juliolopez/ASISTE_PCB/esquematicos.pdf

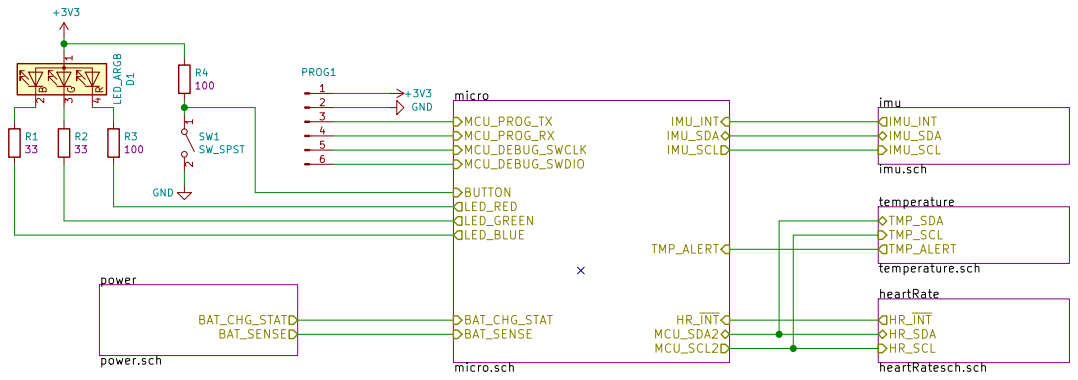
[picture p1: page 1]

Julio López Moya ASISTE

File: ASISTE.sch Sheet: / ASISTE

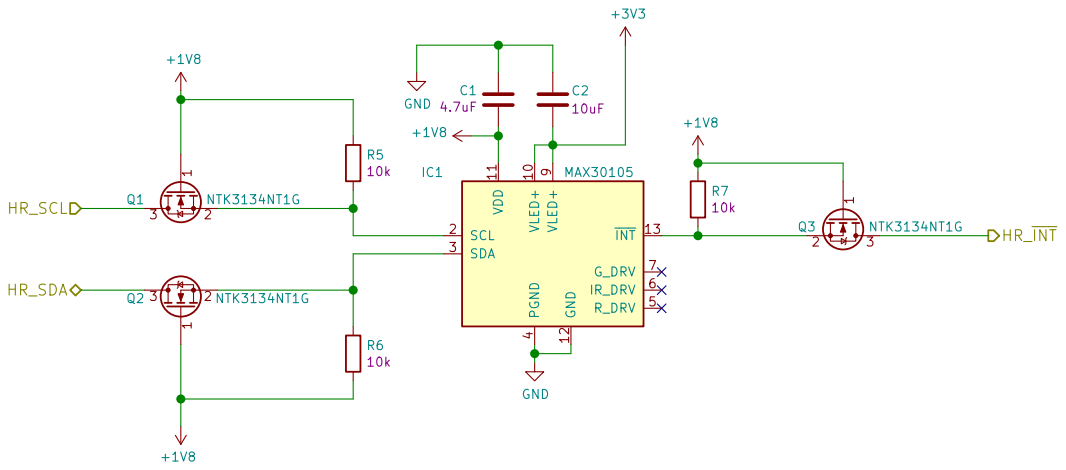
[picture p2: page 2]

Julio López Moya ASISTE

Id: 2/6 Title: Heart Rate & Oximeter File: heartRatesch.sch Sheet: /heartRate/ ASISTE

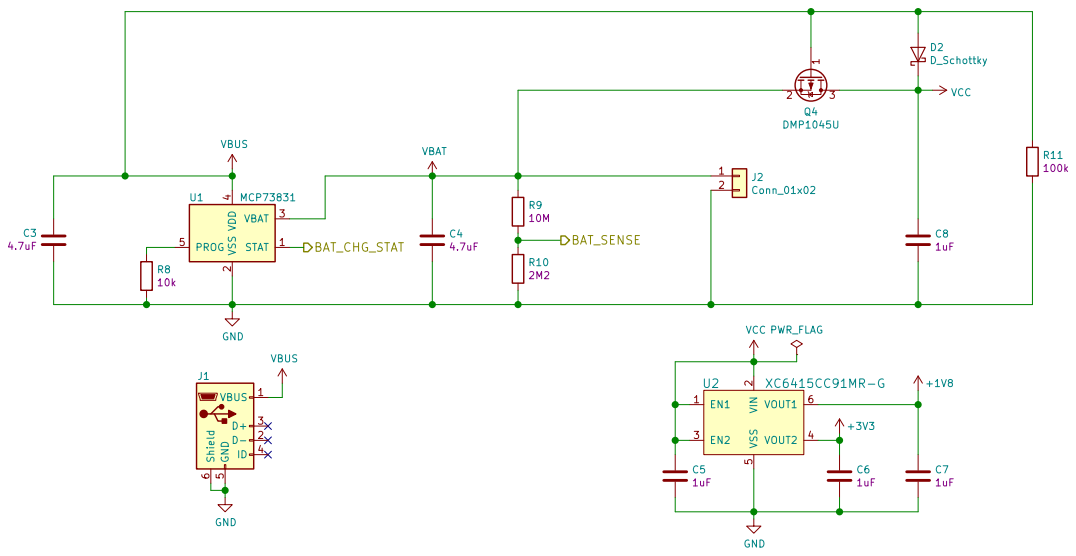
[picture p3: page 3]

Julio López Moya ASISTE

File: power.sch
Id: 3/6 Title: Battery Charger & DC/DC Converters

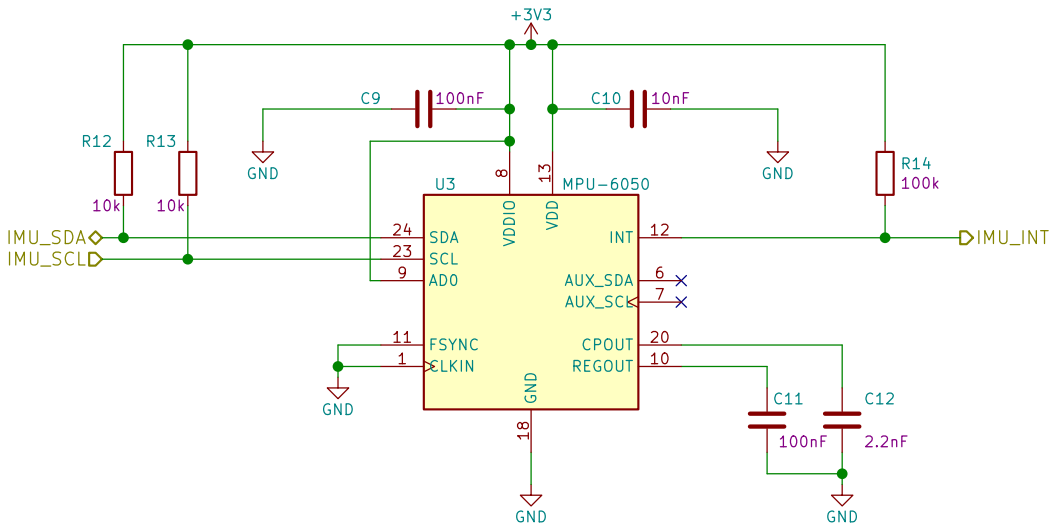
[picture p4: page 4]

Julio López Moya ASISTE

Id: 4/6 Title: Inertial Measurement Unit File: imu.sch Sheet: /imu/ ASISTE

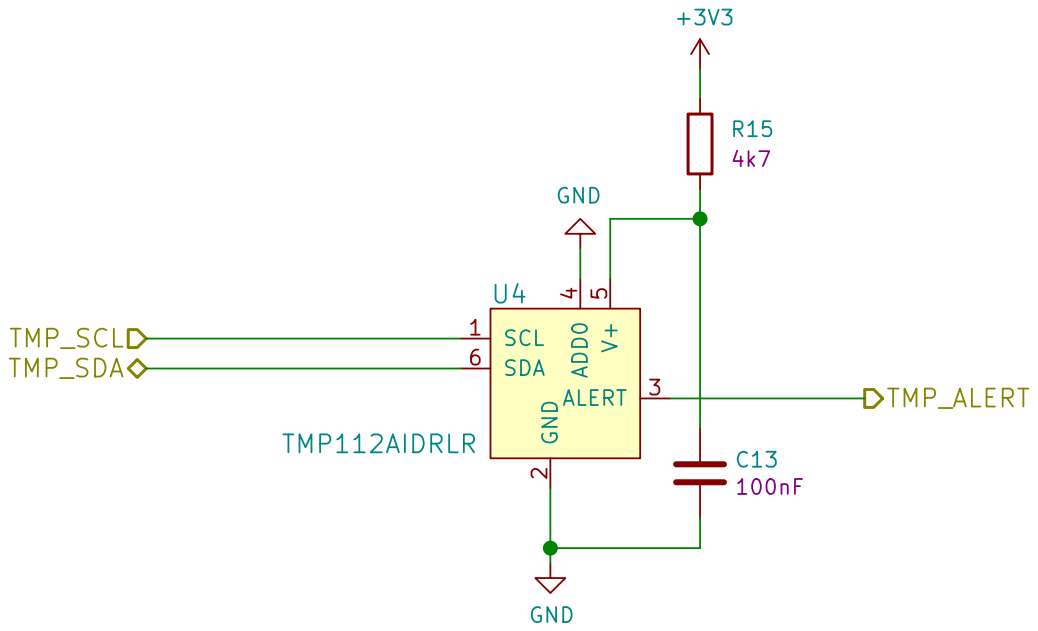
[picture p5: page 5]

Julio López Moya ASISTE

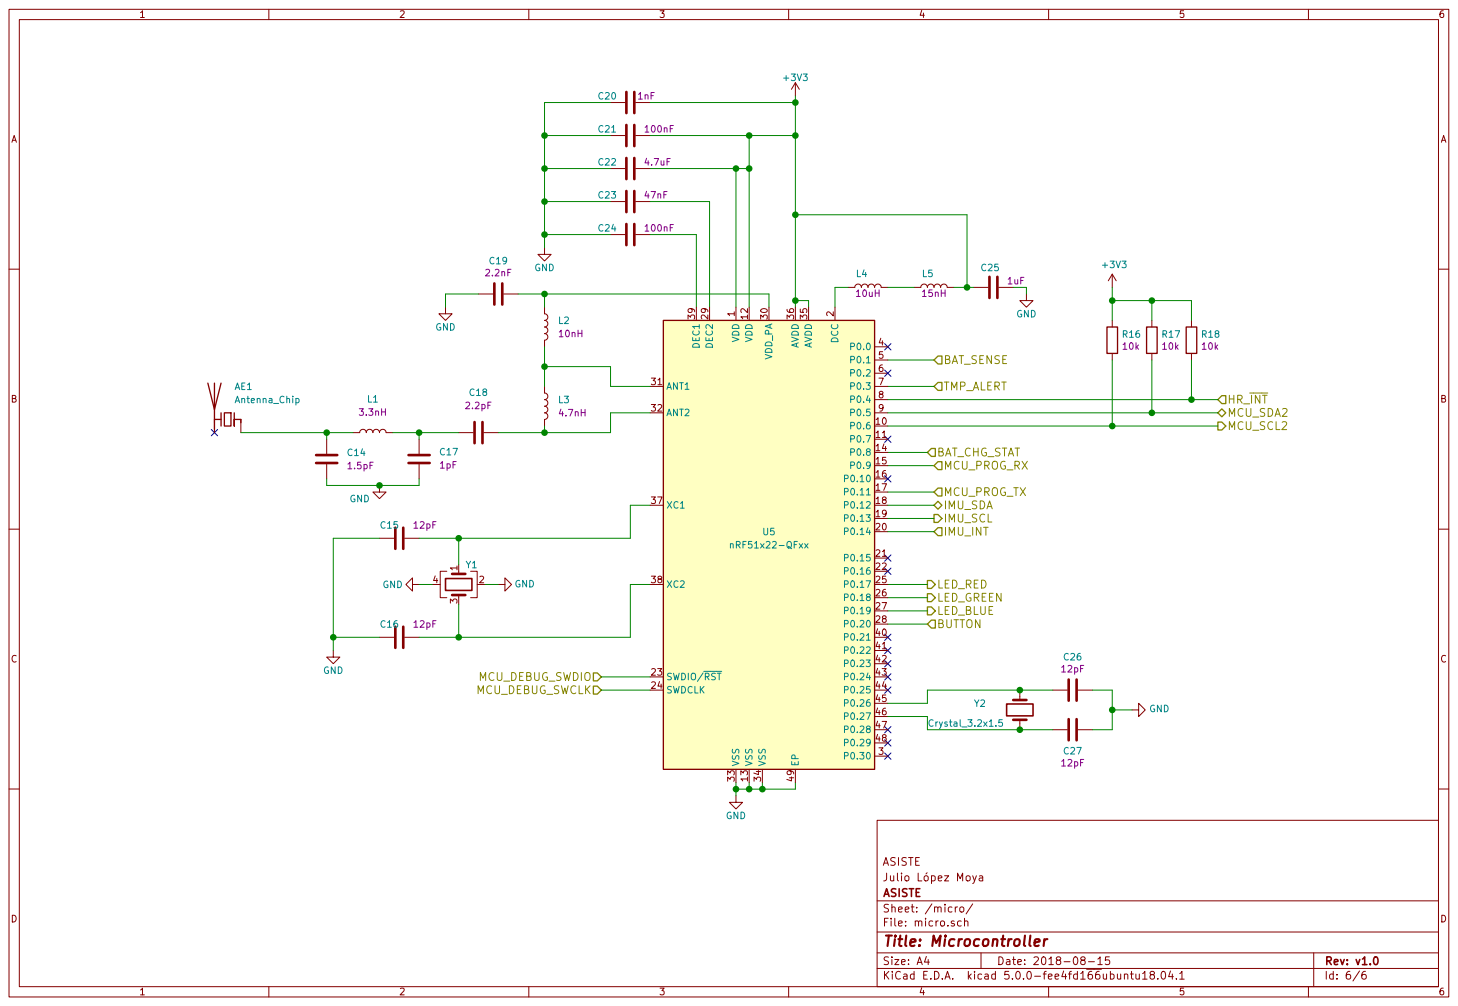
[picture p6: page 6]

2 P0.14 20 P0.15 21 P0.16 22 SWDIO/RST 23 SWDCLK 24 P0.17 25 P0.18 26 P0.19 27 P0.20 28 DEC2 29 P0.30 3 VDD_PA 30 ANT1 31 ANT2 32 VSS 33 VSS 34 AVDD 35 AVDD 36 XC1 37 XC2 38 DEC1 39 P0.0 4 P0.21 40 P0.22 41 P0.23 42 P0.24 43 P0.25 44 P0.26 45 P0.27 46 P0.28 47 P0.29 48 EP 49 P0.1 5 P0.2 6 P0.3 7 P0.4 8 P0.5 9 U5

Julio López Moya ASISTE

Id: 6/6 Title: Microcontroller File: micro.sch Sheet: /micro/ ASISTE
