juliolopez/ASISTE_PCB/power-power.pdf

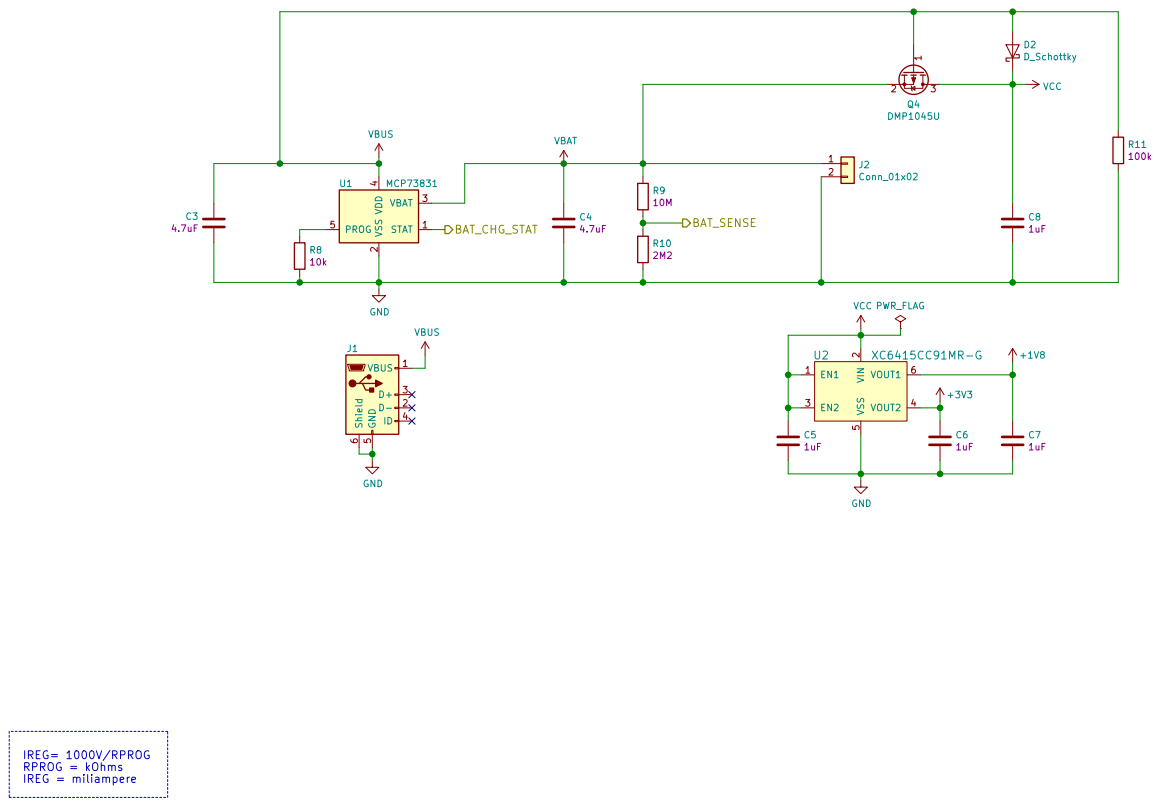
[picture p7: page 1]
