juliolopez/ASISTE_PCB/ASISTE.kicad_pcb

## KiCad design ASISTE.kicad_pcb (2018-09-17)

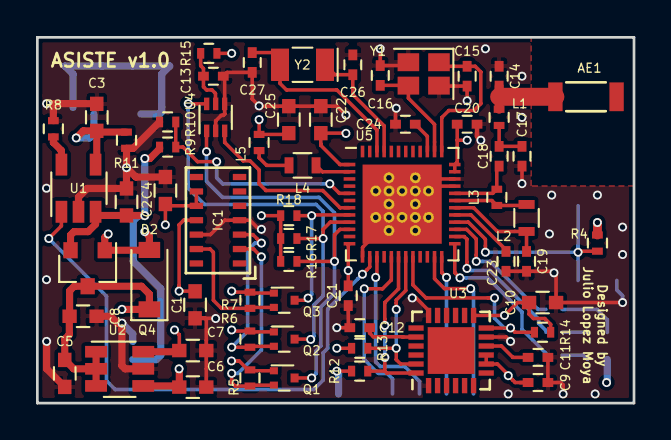
[picture p8: board ASISTE.kicad_pcb from above]

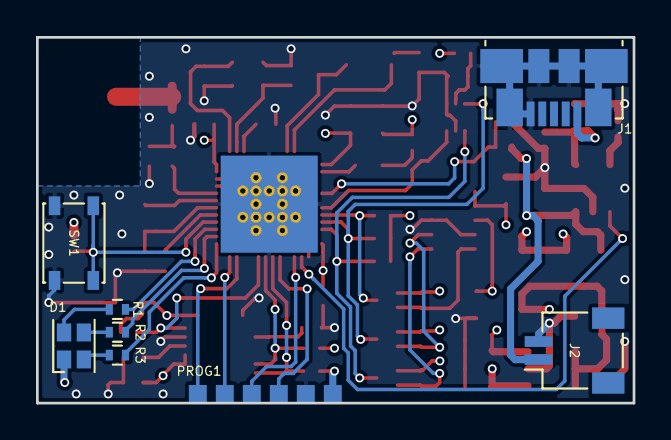
[picture p9: board ASISTE.kicad_pcb from below]

Board: 4 copper layers, 33.1 x 20.3 mm, 69 parts (8 on the bottom side), 46 nets.

Parts:
AE1: Antenna_Chip; ANT
C1, C3, C4, C22: C_0603_4.7uF; C_0603
C2: C_0603_10uF; C_0603
C5, C6, C7, C8, C25: C_0603_1uF; C_0603
C9, C11, C13, C21, C24: C_0402_100nF; C_0402
C10: C_0603_10nF; C_0603
C12, C19: C_0402_2.2nF; C_0402
C14: C_0402_1.5pF; C_0402
C15, C16, C26, C27: C_0402_12pF; C_0402
C17: C_0402_1pF; C_0402
C18: C_0402_2.2pF; C_0402
C20: C_0402_1nF; C_0402
C23: C_0402_47nF; C_0402
D1: LED_ARGB; LED_Cree-PLCC4_2x2mm_CW
D2: D_Schottky; D_SOD-123
IC1: MAX30105; Maxim_OLGA-14_3.3x5.6mm_P0.8mm
J1: USB_B_Micro_SMD; USB_Micro-B_Molex_47346-0001
J2: Conn_01x02; JST_SH_SM02B-SRSS-TB_1x02-1MP_P1.00mm_Horizontal
L1: L_0402_3.3nH; L_0402
L2: L_0603_10nH; L_0603
L3: L_0402_4.7nH; L_0402
L4: L_0603_10uH; L_0603
L5: L_0402_15nH; L_0402
PROG1: SMD_01x06; SMD_PROG
Q1, Q2, Q3: NTK3134NT1G; SOT-723
Q4: DMP1045U; SOT-23
R1, R2: R_0402_33; R_0402
R3, R4: R_0402_100; R_0402
R5, R6, R7, R12, R13, R16, R17, R18: R_0402_10k; R_0402
R8: R_0402_2k; R_0402
R9: R_0402_10M; R_0402
R10: R_0402_2M2; R_0402
R11, R14: R_0402_100k; R_0402
R15: R_0402_4k7; R_0402
SW1: SW_SPST; SW_SPST_PTS810
U1: MCP73831; TSOT-23-5
U2: XC6415CC91MR-G; TSOT-23-6
U3: MPU-6050; QFN-24-1EP_4x4mm_Pitch0.5mm
U4: TMP112AIDRLR; SOT-563
U5: nRF51x22-QFxx; QFN-48-1EP_6x6mm_Pitch0.4mm_ThermalVias
Y1: Crystal_GND24_2520; Crystal_SMD_2520-4pin_2.5x2.0mm
Y2: Crystal_3.2x1.5; Crystal_SMD_G8-2Pin_3.2x1.5mm

Connections:
+1V8: C1.1, C7.1, IC1.11, Q1.1, Q2.1, Q3.1, R5.1, R6.2, R7.1, U2.6
+3V3: C2.2, C6.1, C9.1, C10.2, C20.1, C21.1, C22.1, C25.2, D1.1, IC1.9, IC1.10, L5.2, PROG1.1, R4.1, R12.1, R13.1, R14.1, R15.1, R16.1, R17.1, R18.1, U2.4, U3.8, U3.9, U3.13, U5.1, U5.12, U5.35, U5.36
/heartRate/HR_SCL: Q1.3, R16.2, U4.1, U5.10
/heartRate/HR_SDA: Q2.3, R17.2, U4.6, U5.9
/heartRate/HR_~INT: Q3.3, R18.2, U5.8
/imu/IMU_INT: R14.2, U3.12, U5.20
/imu/IMU_SCL: R13.2, U3.23, U5.19
/imu/IMU_SDA: R12.2, U3.24, U5.18
/micro/BAT_CHG_STAT: U1.1, U5.14
/micro/BAT_SENSE: R9.2, R10.1, U5.5
/micro/BUTTON: R4.2, SW1.1, U5.28
/micro/LED_BLUE: R1.2, U5.27
/micro/LED_GREEN: R2.2, U5.26
/micro/LED_RED: R3.2, U5.25
/micro/MCU_DEBUG_SWCLK: PROG1.5, U5.24
/micro/MCU_DEBUG_SWDIO: PROG1.6, U5.23
/micro/MCU_PROG_RX: PROG1.4, U5.15
/micro/MCU_PROG_TX: PROG1.3, U5.17
/micro/TMP_ALERT: U4.3, U5.7
GND: C1.2, C2.1, C3.1, C4.2, C5.2, C6.2, C7.2, C8.2, C9.2, C10.1, C11.2, C12.2, C13.2, C14.2, C15.2, C16.2, C17.1, C19.2, C20.2, C21.2, C22.2, C23.2, C24.2, C25.1, C26.1, C27.1, IC1.4, IC1.12, J1.5, J1.6, J2.2, PROG1.2, R8.2, R10.2, R11.2, SW1.2, U1.2, U2.5, U3.1, U3.11, U3.18, U4.2, U4.4, U5.13, U5.33, U5.34, U5.49, Y1.2, Y1.4
unnamed: AE1.1, C14.1, L1.1
unnamed: C11.1, U3.10
unnamed: C12.1, U3.20
unnamed: C13.1, R15.2, U4.5
unnamed: C15.1, U5.37, Y1.1
unnamed: C16.1, U5.38, Y1.3
unnamed: C17.2, C18.1, L1.2
unnamed: C18.2, L3.2, U5.32
unnamed: C19.1, L2.1, U5.30
unnamed: C23.1, U5.29
unnamed: C24.1, U5.39
unnamed: C26.2, U5.45, Y2.1
unnamed: C27.2, U5.46, Y2.2
unnamed: D1.2, R1.1
unnamed: D1.3, R2.1
unnamed: D1.4, R3.1
unnamed: IC1.2, Q1.2, R5.2
unnamed: IC1.3, Q2.2, R6.1
unnamed: IC1.13, Q3.2, R7.2
unnamed: L2.2, L3.1, U5.31
unnamed: L4.1, U5.2
unnamed: L4.2, L5.1
unnamed: R8.1, U1.5
VBAT: C4.1, J2.1, Q4.2, R9.1, U1.3
VBUS: C3.2, D2.2, J1.1, Q4.1, R11.1, U1.4
VCC: C5.1, C8.1, D2.1, Q4.3, U2.1, U2.2, U2.3
