juliolopez/ASISTE_PCB/(commit log)

2018-07-13 primer commit
    [ASISTE.kicad_pcb, ASISTE.sch, imu.sch, microcontroller.sch]
2018-08-20 Esquemático a falta de incluir el conversor DC/DC
    [ASISTE-2018-07-22-08-44-10.sch, heartRatesch.sch, imu-2018-07-22-08-44-10.sch, micro.sch, microcontroller-2018-07-22-08-44-10.sch, power.sch, temperature.sch]
2018-08-29 Terminado esquemático. Falta revisar
    [ASISTE.sch, heartRatesch.sch, micro.sch, power.sch]
2018-08-29 Esquemático parcialmente revisado. Falta revisar pines y correspondencia con footprints
    [ASISTE.sch, heartRatesch.sch, imu.sch, micro.sch, power.sch, temperature.sch]
2018-09-05 Añadido botón y otros
    [ASISTE.sch, imu.sch, micro.sch, temperature.sch]
2018-09-12 Esquemáticos totalmente terminados y revisados PCB a falta de routear el puerto de programación
    [ASISTE.sch, heartRatesch.sch, imu.sch, micro.sch, power.sch, temperature.sch]
